snckwf/gps-speedometer-esp32-tm1637/case_3d/images/case_coperchio_sotto.png

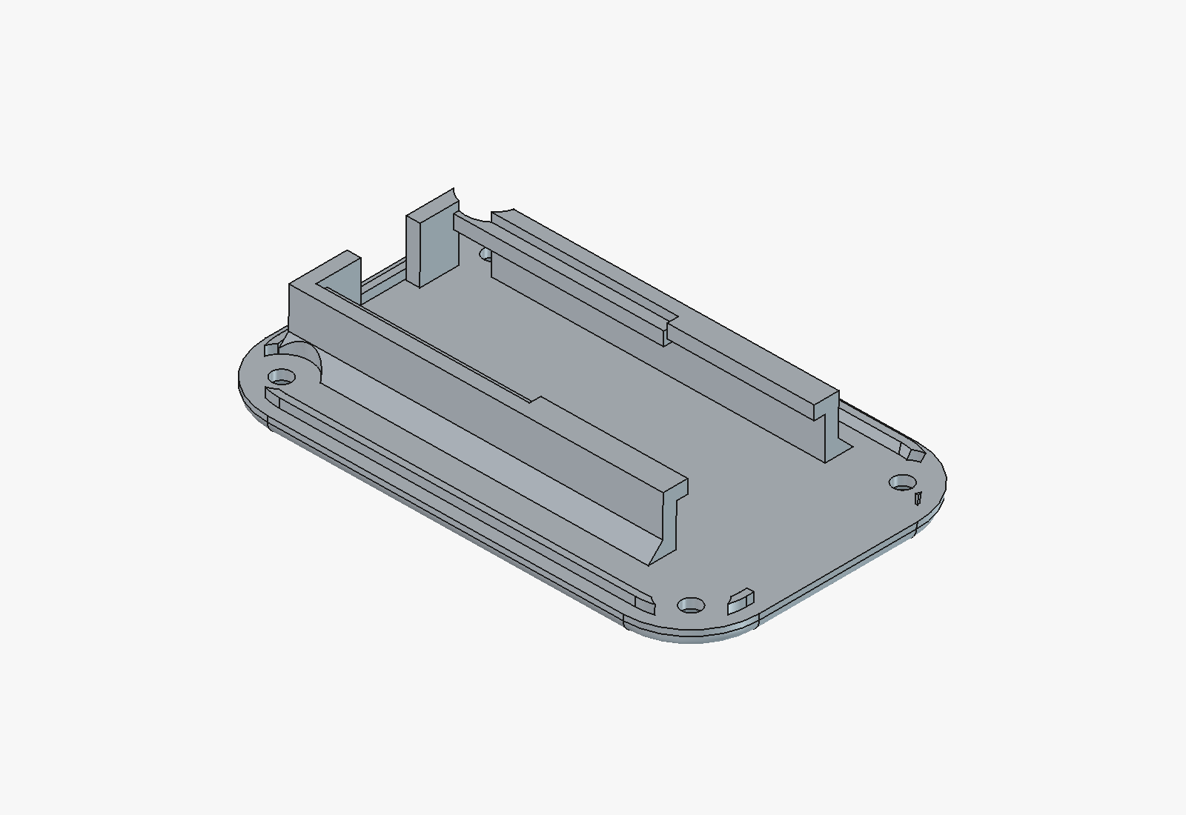
case_3d/images/case_coperchio_sotto.png
