snckwf/gps-speedometer-esp32-tm1637/case_3d/images/case_interno.png

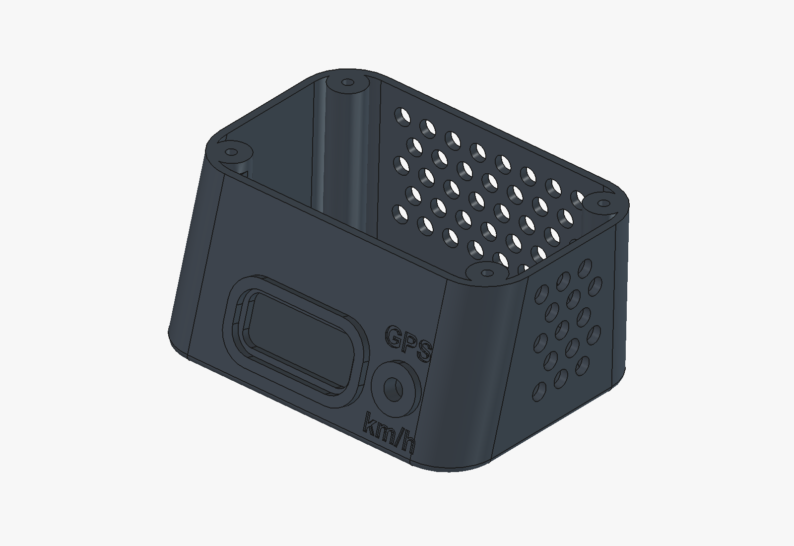
case_3d/images/case_interno.png
