snckwf/gps-speedometer-esp32-tm1637/images/cover-gps-speedometer-esp32.png

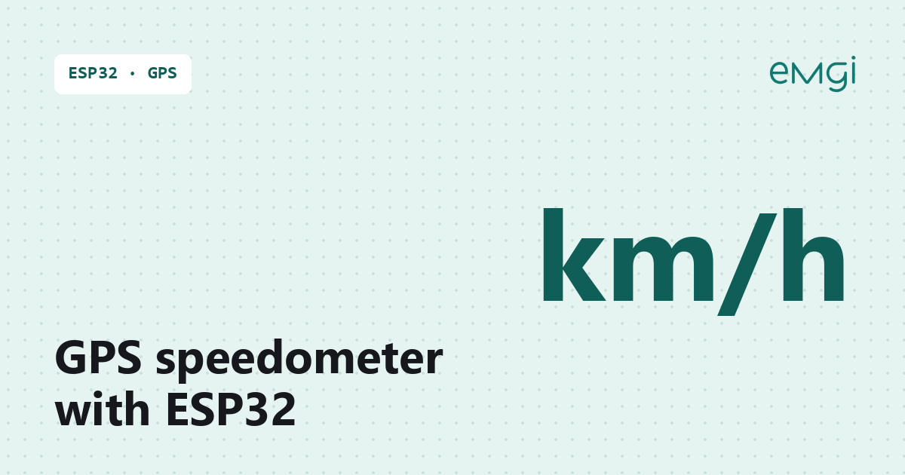
images/cover-gps-speedometer-esp32.png
