snckwf/gps-speedometer-esp32-tm1637/case_3d/step/case_tachimetro_gps.step

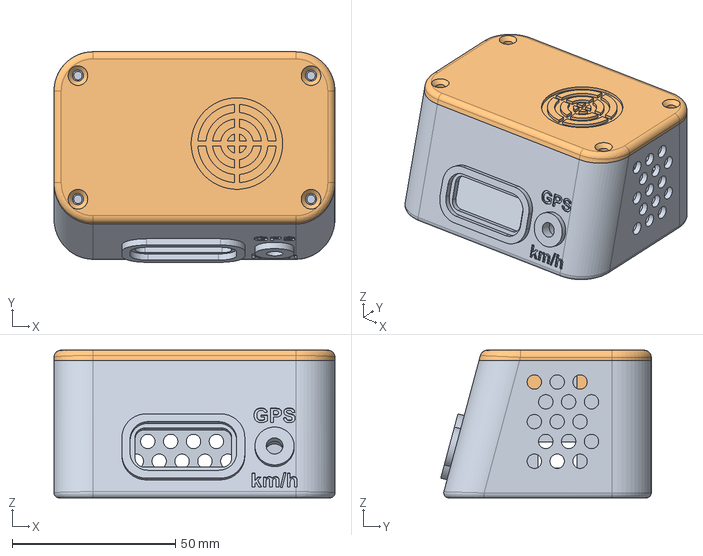
[picture p7: CAD file, 2026-11-11]
case_3d/step/case_tachimetro_gps.step
86.0 x 64.5 x 45.2 mm
