snckwf/gps-speedometer-esp32-tm1637/case_3d/stl/tachimetro_base.stl

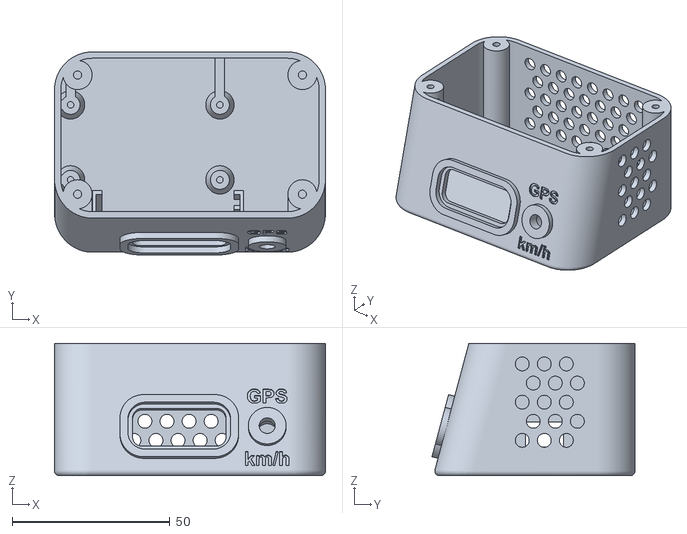
[picture p8: CAD file, 2026-11-11]
case_3d/stl/tachimetro_base.stl
86.0 x 64.5 x 42.0
