snckwf/gps-speedometer-esp32-tm1637/case_3d/stl/tachimetro_coperchio.stl

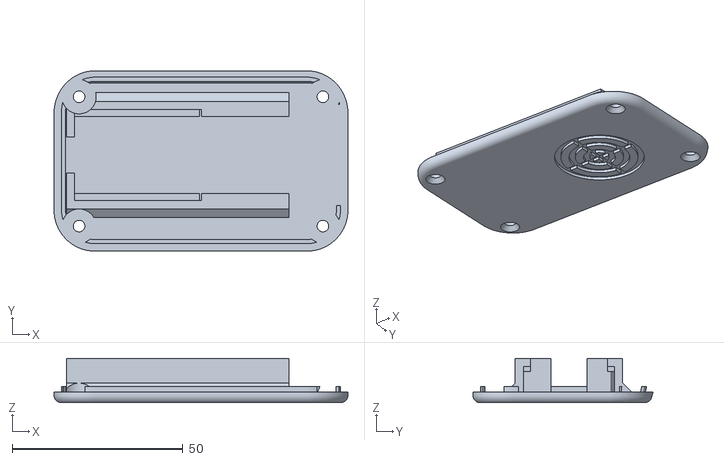
[picture p9: CAD file, 2026-11-11]
case_3d/stl/tachimetro_coperchio.stl
86.0 x 52.7 x 13.0
