snckwf/gps-speedometer-esp32-tm1637/(list of files, cad)

Other CAD files:
case_3d/freecad/case_tachimetro_gps.FCStd
