snckwf/gps-speedometer-esp32-tm1637/(commit log)

2026-11-07 Add 3D-printed wedge case (STL, STEP, FreeCAD source, images) and README section
    Claude-Session: https://claude.ai/code/session_01Vod8kb5Hf61VA14zXqQ2LV
    [case_tachimetro_gps.FCStd, case_tachimetro_gps.step, tachimetro_base.stl, tachimetro_coperchio.stl]
2026-11-07 New cover with the 3D-printed case render (display and LED)
    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
2026-11-08 Update 3D case: display window and LED position, ESP32 conical standoffs, new cover and images
    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
    [case_tachimetro_gps.FCStd, case_tachimetro_gps.step, tachimetro_base.stl]
2026-11-10 Case: taller body (Dupont clearance), wider lid grooves, new cover and images
    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
    [case_tachimetro_gps.FCStd, case_tachimetro_gps.step, tachimetro_base.stl, tachimetro_coperchio.stl]
2026-11-11 Case: body 4 mm taller and ESP32 standoffs 4 mm higher, new cover and images
    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
    [case_tachimetro_gps.FCStd, case_tachimetro_gps.step, tachimetro_base.stl, tachimetro_coperchio.stl]
